Csordi/JK-FlipFlop-24H-Clock/TTL_Clock.jpg

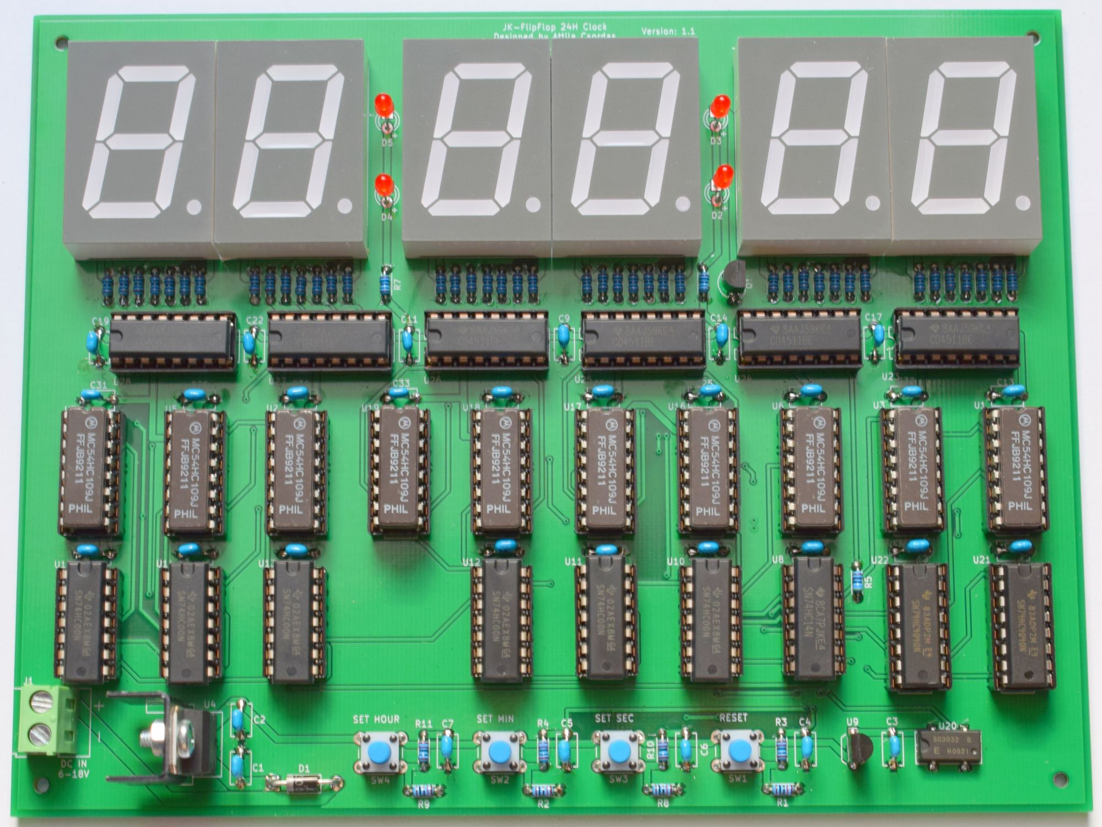
TTL_Clock.jpg
