Csordi/JK-FlipFlop-24H-Clock/Schematic.pdf

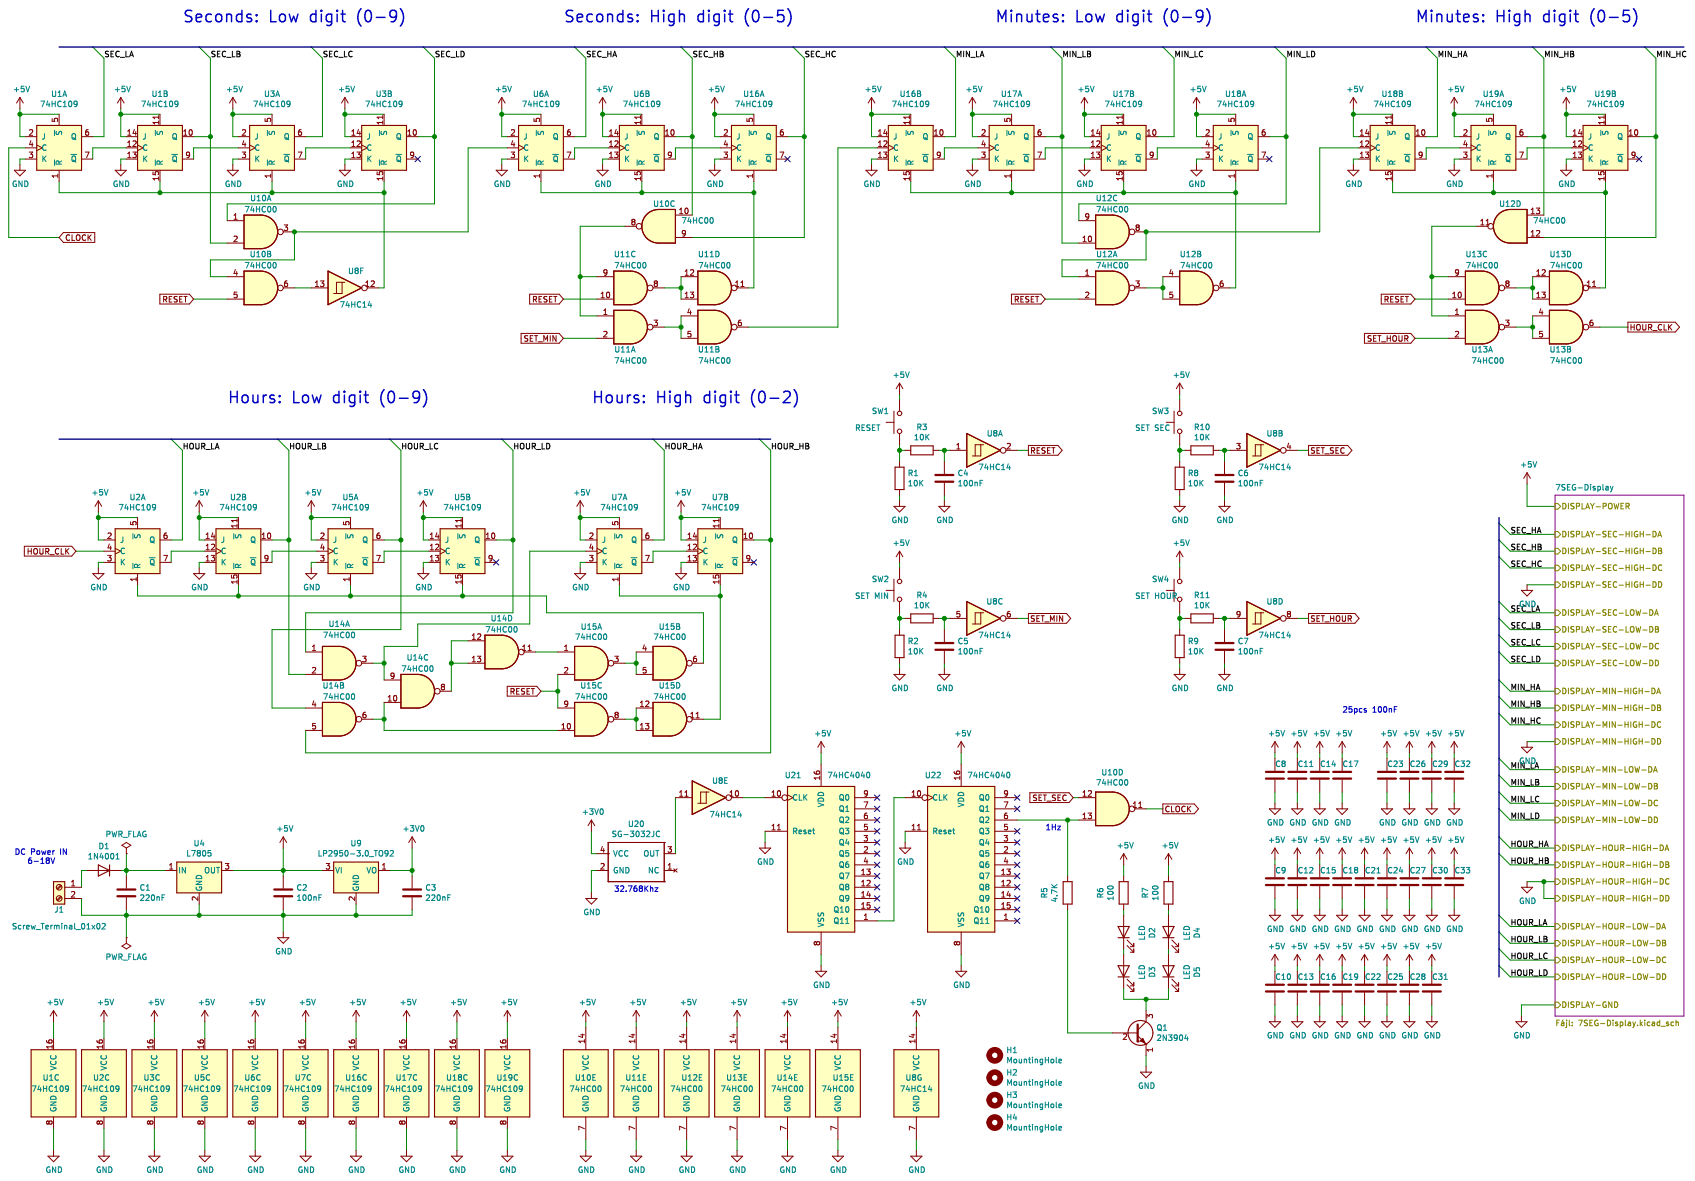
[picture p2: page 1]

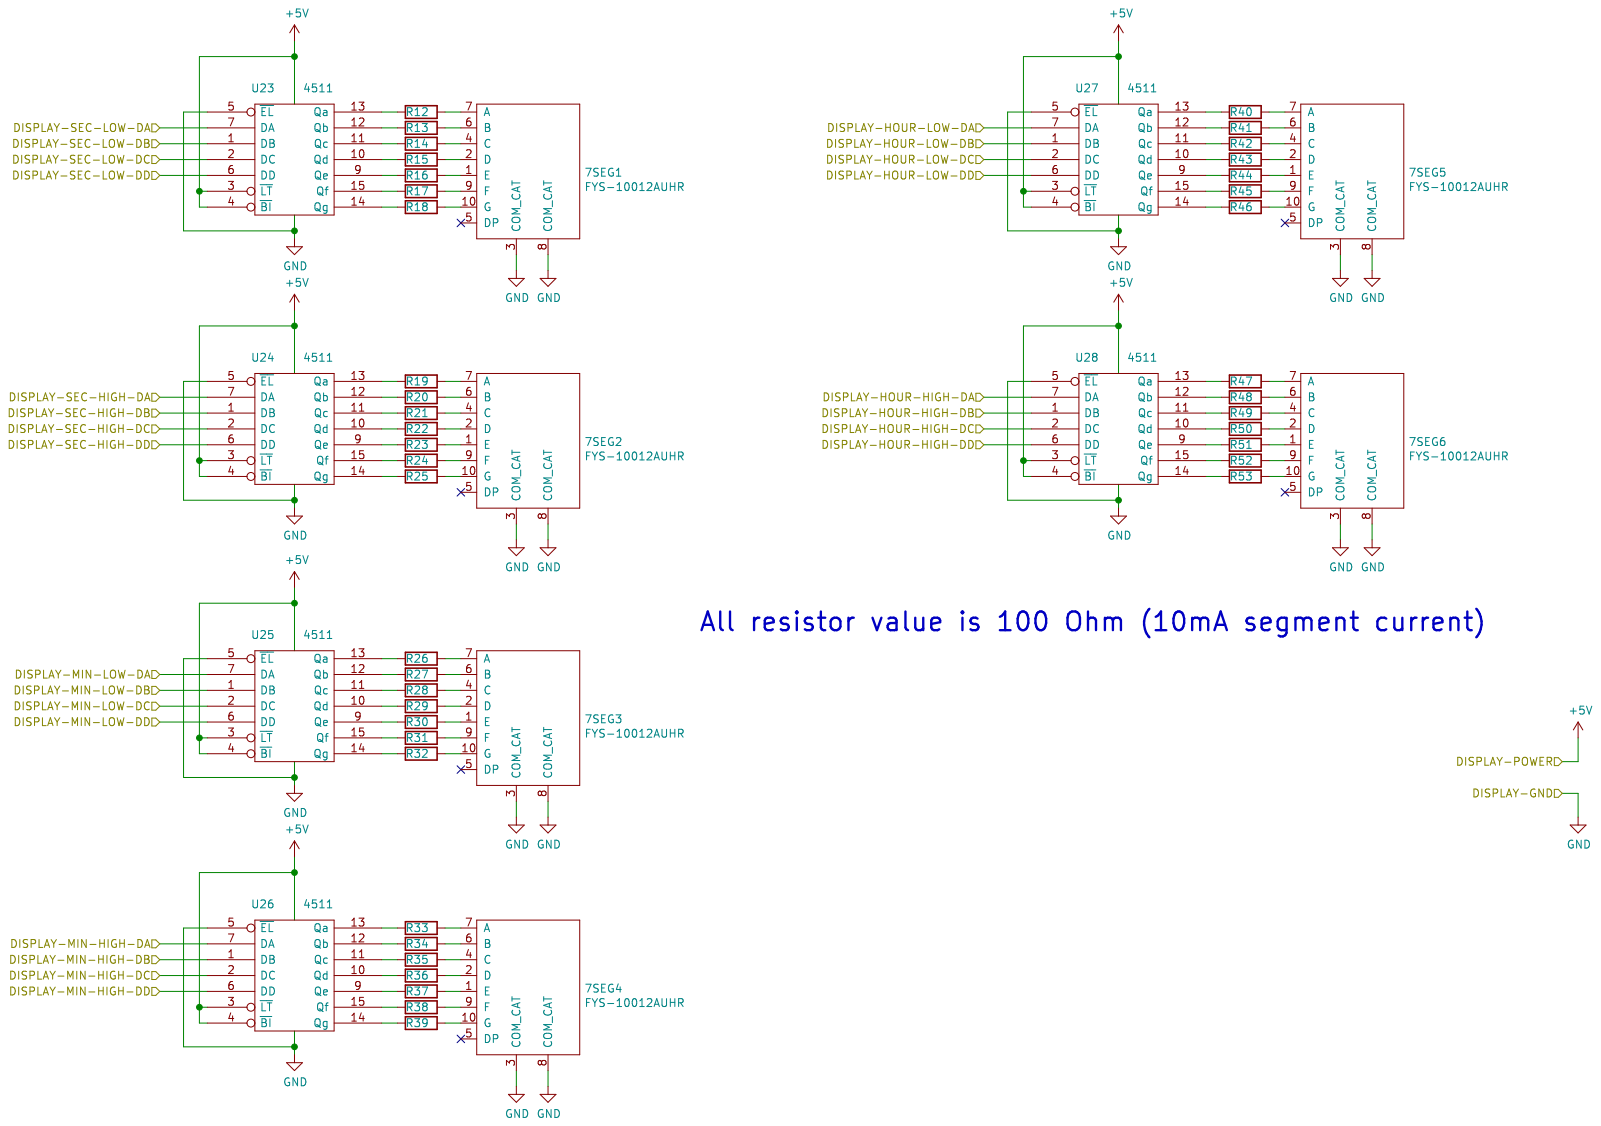
[picture p3: page 2]
