Csordi/JK-FlipFlop-24H-Clock/PCB.pdf

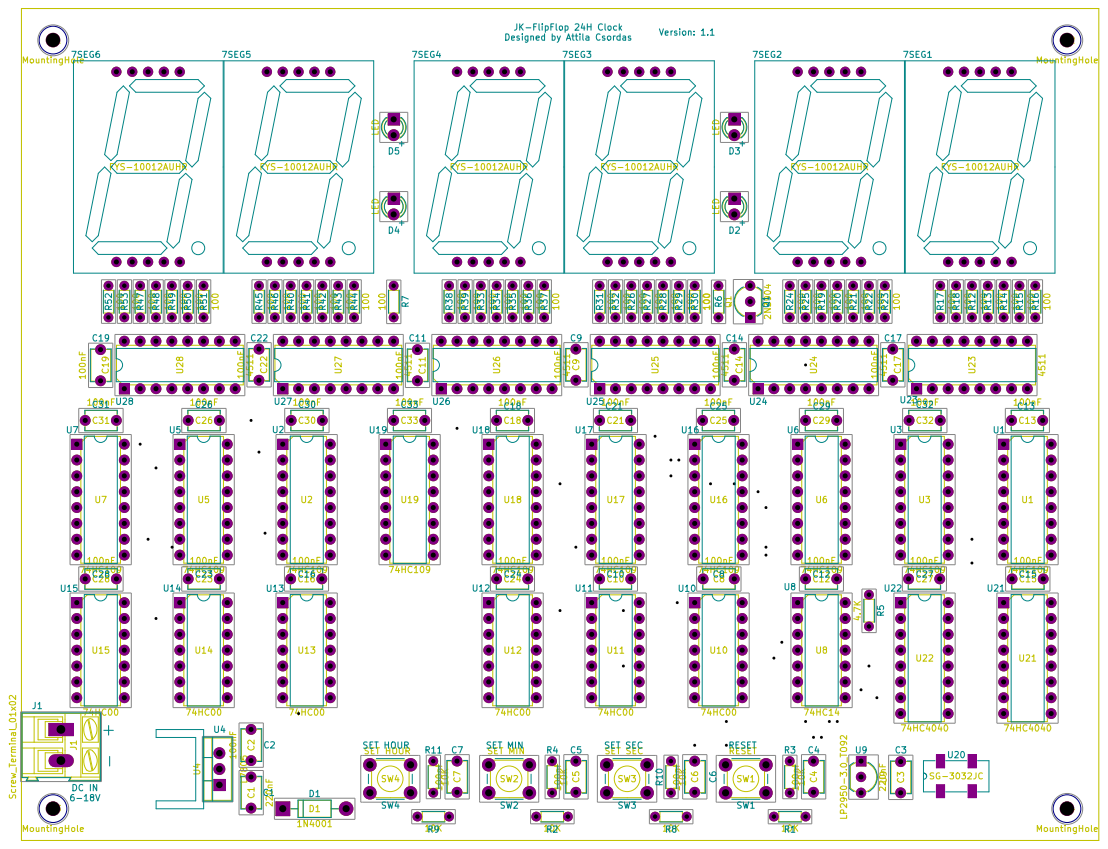
[picture p4: page 1]
