Csordi/JK-FlipFlop-24H-Clock/JK-FLipFlop-24H-Clock.kicad_pcb

## KiCad design JK-FLipFlop-24H-Clock.kicad_pcb (2024-03-14)

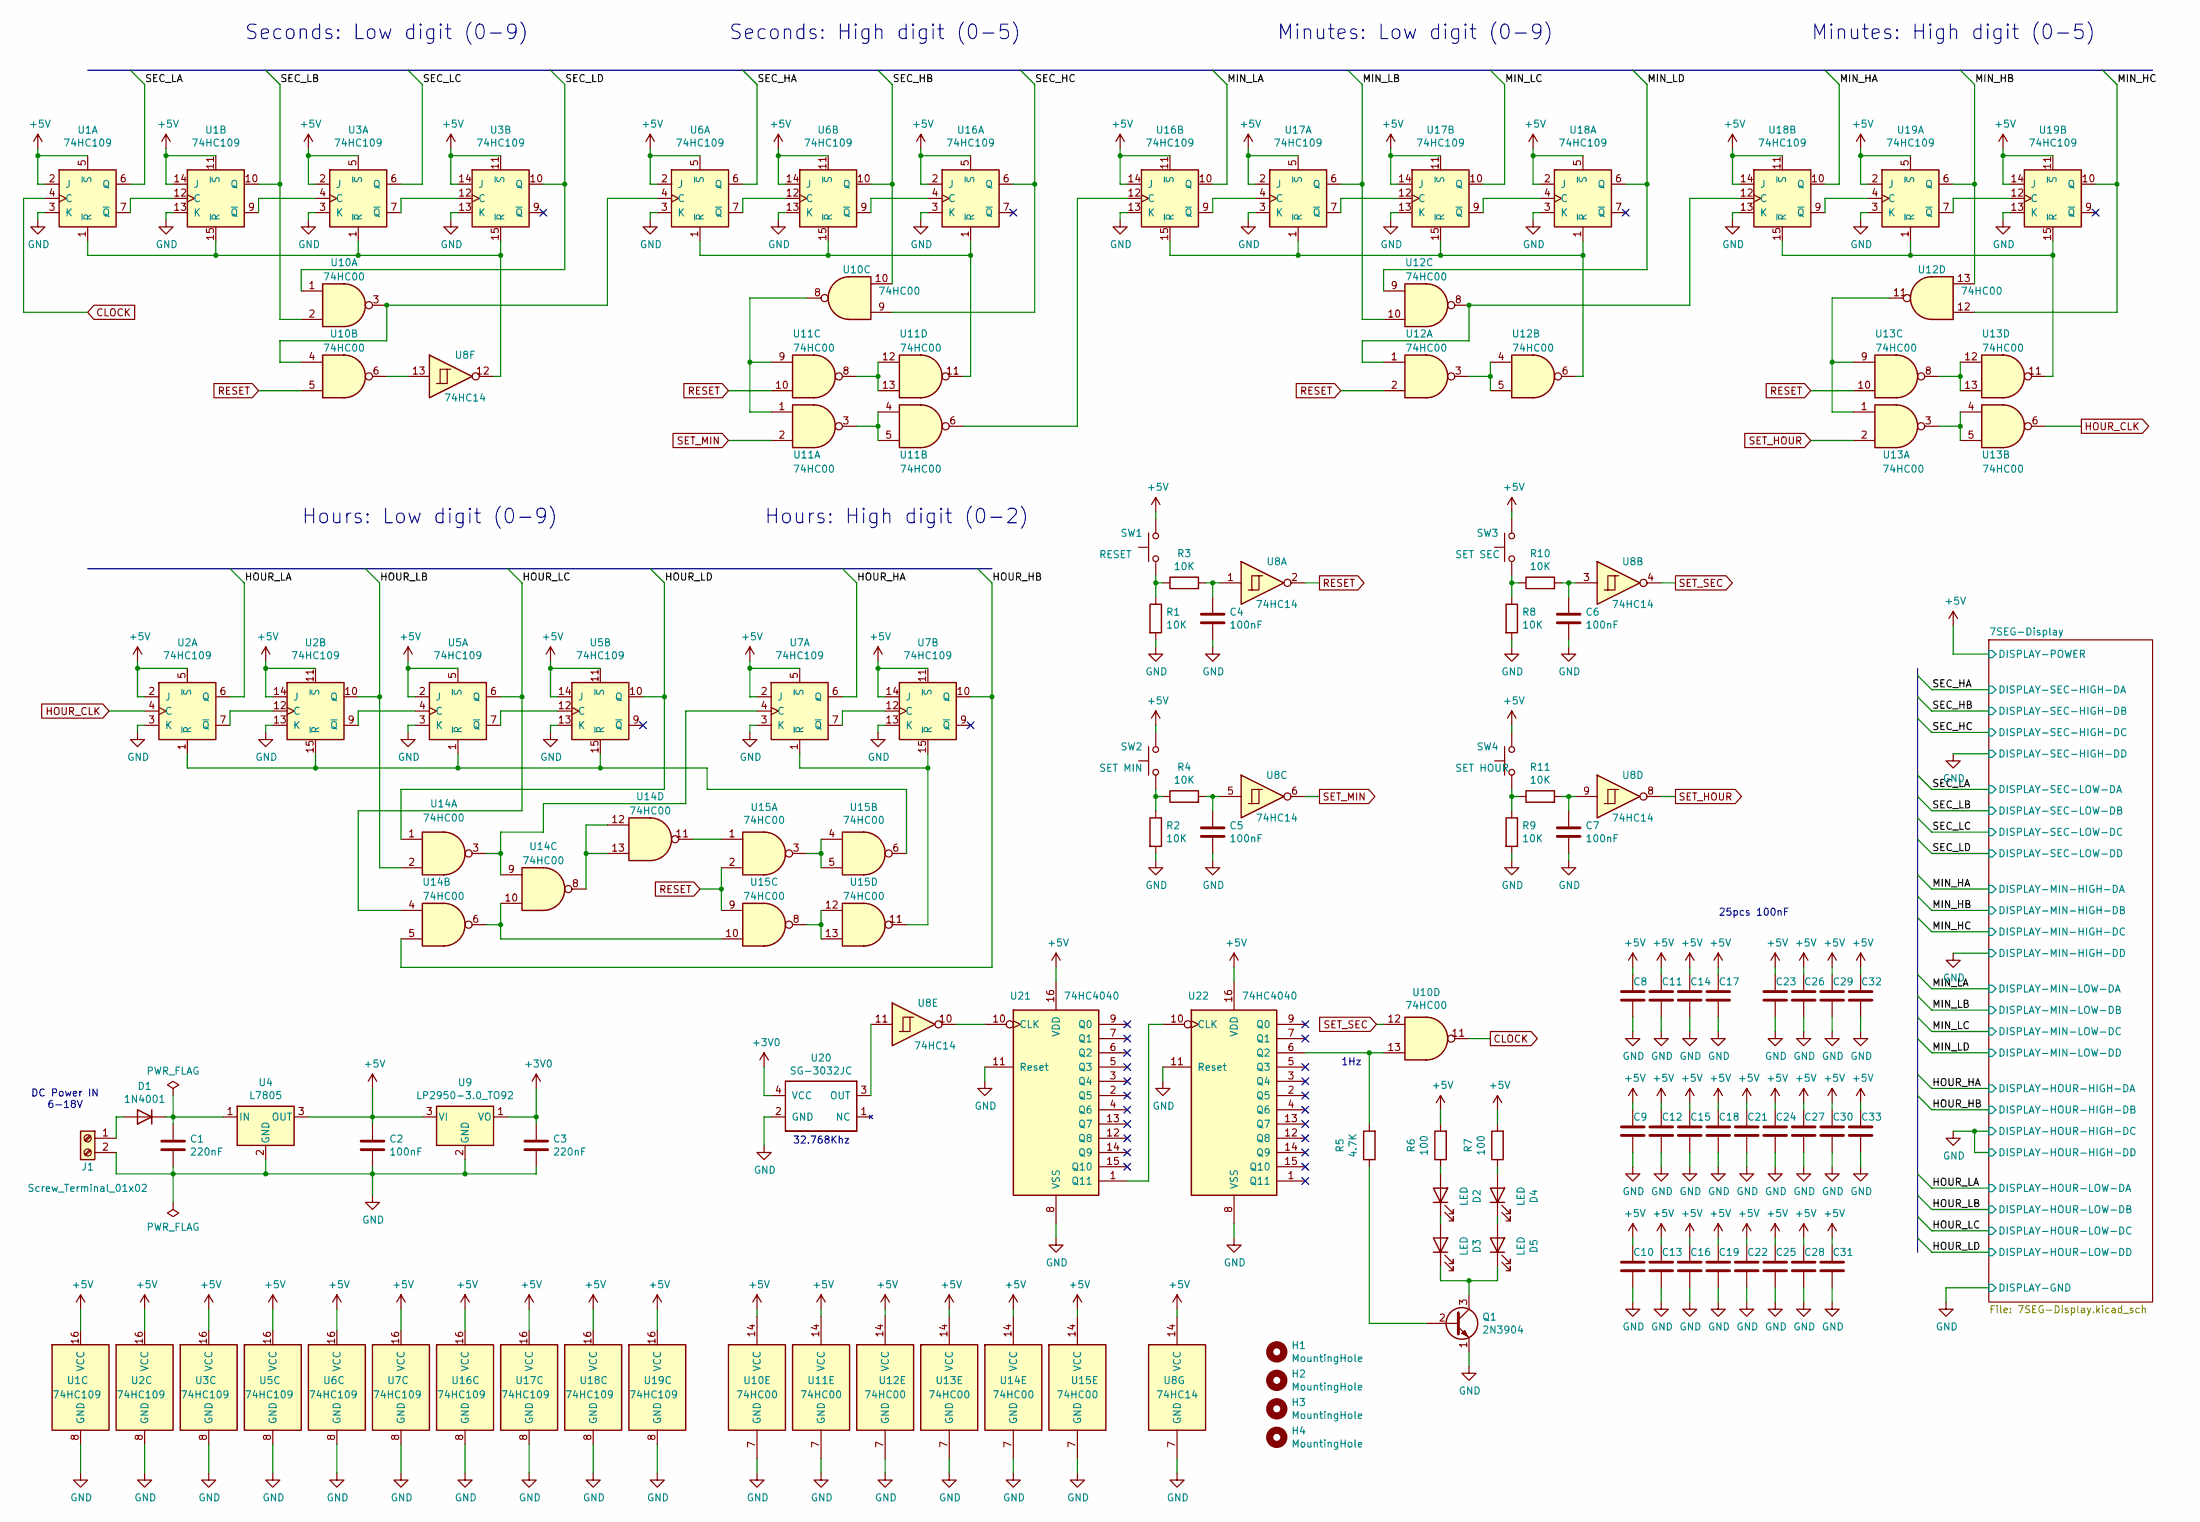
[picture p5: schematic JK-FLipFlop-24H-Clock.kicad_sch, J-K Flip/Flip 24H Clock]

Parts:
C1, C3: 220nF; C_Disc_D5.1mm_W3.2mm_P5.00mm
C2, C4, C5, C6, C7, C8, C9, C10, C11, C12, C13, C14, C15, C16, C17, C18, C19, C21, C22, C23, C24, C25, C26, C27, C28, C29, C30, C31, C32, C33: 100nF; C_Disc_D5.1mm_W3.2mm_P5.00mm
D1: 1N4001; D_DO-41_SOD81_P10.16mm_Horizontal
D2, D3, D4, D5: LED; LED_D3.0mm
H1, H2, H3, H4: MountingHole; MountingHole_2.2mm_M2
J1: Screw_Terminal_01x02; TerminalBlock_Altech_AK300-2_P5.00mm
Q1: 2N3904; TO-92_Inline_Wide
R1, R2, R3, R4, R8, R9, R10, R11: 10K; R_Axial_DIN0204_L3.6mm_D1.6mm_P5.08mm_Horizontal
R5: 4.7K; R_Axial_DIN0204_L3.6mm_D1.6mm_P5.08mm_Horizontal
R6, R7: 100; R_Axial_DIN0204_L3.6mm_D1.6mm_P5.08mm_Horizontal
SW1: RESET; SW_PUSH_6mm
SW2: SET MIN; SW_PUSH_6mm
SW3: SET SEC; SW_PUSH_6mm
SW4: SET HOUR; SW_PUSH_6mm
U1, U2, U3, U5, U6, U7, U16, U17, U18, U19: 74HC109; DIP-16_W7.62mm
U4: L7805; TO-220-3_Vertical
U8: 74HC14; DIP-14_W7.62mm
U9: LP2950-3.0_TO92; TO-92_Inline_Wide
U10, U11, U12, U13, U14, U15: 74HC00; DIP-14_W7.62mm
U20: SG-3032JC; SG-3030JC
U21, U22: 74HC4040; DIP-16_W7.62mm

Connections:
+3V0: C3.1, U9.1 (VO), U20.4 (VCC)
+5V: C2.1, C8.1, C9.1, C10.1, C11.1, C12.1, C13.1, C14.1, C15.1, C16.1, C17.1, C18.1, C19.1, C21.1, C22.1, C23.1, C24.1, C25.1, C26.1, C27.1, C28.1, C29.1, C30.1, C31.1, C32.1, C33.1, R6.2, R7.2, SW1.2, SW2.2, SW3.2, SW4.2, U1.2 (J), U1.5 (~S), U1.11 (~S), U1.14 (J), U1.16 (VCC), U2.2 (J), U2.5 (~S), U2.11 (~S), U2.14 (J), U2.16 (VCC), U3.2 (J), U3.5 (~S), U3.11 (~S), U3.14 (J), U3.16 (VCC), U4.3 (OUT), U5.2 (J), U5.5 (~S), U5.11 (~S), U5.14 (J), U5.16 (VCC), U6.2 (J), U6.5 (~S), U6.11 (~S), U6.14 (J), U6.16 (VCC), U7.2 (J), U7.5 (~S), U7.11 (~S), U7.14 (J), U7.16 (VCC), U8.14 (VCC), U9.3 (VI), U10.14 (VCC), U11.14 (VCC), U12.14 (VCC), U13.14 (VCC), U14.14 (VCC), U15.14 (VCC), U16.2 (J), U16.5 (~S), U16.11 (~S), U16.14 (J), U16.16 (VCC), U17.2 (J), U17.5 (~S), U17.11 (~S), U17.14 (J), U17.16 (VCC), U18.2 (J), U18.5 (~S), U18.11 (~S), U18.14 (J), U18.16 (VCC), U19.2 (J), U19.5 (~S), U19.11 (~S), U19.14 (J), U19.16 (VCC), U21.16 (VDD), U22.16 (VDD); also elsewhere on the board
/HOUR_HA: U7.6 (Q); also elsewhere on the board
/HOUR_HB: U7.10 (Q), U14.5; also elsewhere on the board
/HOUR_LA: U2.6 (Q); also elsewhere on the board
/HOUR_LB: U2.10 (Q), U14.2; also elsewhere on the board
/HOUR_LC: U5.6 (Q), U14.4; also elsewhere on the board
/HOUR_LD: U5.10 (Q), U14.1; also elsewhere on the board
/MIN_HA: U18.10 (Q); also elsewhere on the board
/MIN_HB: U12.13, U19.6 (Q); also elsewhere on the board
/MIN_HC: U12.12, U19.10 (Q); also elsewhere on the board
/MIN_LA: U16.10 (Q); also elsewhere on the board
/MIN_LB: U12.10, U17.6 (Q); also elsewhere on the board
/MIN_LC: U17.10 (Q); also elsewhere on the board
/MIN_LD: U12.9, U18.6 (Q); also elsewhere on the board
/SEC_HA: U6.6 (Q); also elsewhere on the board
/SEC_HB: U6.10 (Q), U10.10; also elsewhere on the board
/SEC_HC: U10.9, U16.6 (Q); also elsewhere on the board
/SEC_LA: U1.6 (Q); also elsewhere on the board
/SEC_LB: U1.10 (Q), U10.2; also elsewhere on the board
/SEC_LC: U3.6 (Q); also elsewhere on the board
/SEC_LD: U3.10 (Q), U10.1; also elsewhere on the board
CLOCK: U1.4 (C), U10.11
GND: C1.2, C2.2, C3.2, C4.2, C5.2, C6.2, C7.2, C8.2, C9.2, C10.2, C11.2, C12.2, C13.2, C14.2, C15.2, C16.2, C17.2, C18.2, C19.2, C21.2, C22.2, C23.2, C24.2, C25.2, C26.2, C27.2, C28.2, C29.2, C30.2, C31.2, C32.2, C33.2, J1.2, Q1.1 (E), R1.2, R2.2, R8.2, R9.2, U1.3 (K), U1.8 (GND), U1.13 (K), U2.3 (K), U2.8 (GND), U2.13 (K), U3.3 (K), U3.8 (GND), U3.13 (K), U4.2 (GND), U5.3 (K), U5.8 (GND), U5.13 (K), U6.3 (K), U6.8 (GND), U6.13 (K), U7.3 (K), U7.8 (GND), U7.13 (K), U8.7 (GND), U9.2 (GND), U10.7 (GND), U11.7 (GND), U12.7 (GND), U13.7 (GND), U14.7 (GND), U15.7 (GND), U16.3 (K), U16.8 (GND), U16.13 (K), U17.3 (K), U17.8 (GND), U17.13 (K), U18.3 (K), U18.8 (GND), U18.13 (K), U19.3 (K), U19.8 (GND), U19.13 (K), U20.2 (GND), U21.8 (VSS), U21.11 (Reset), U22.8 (VSS), U22.11 (Reset); also elsewhere on the board
HOUR_CLK: U2.4 (C), U13.6
unnamed: C1.1, D1.1 (K), U4.1 (IN)
unnamed: C4.1, R3.2, U8.1
unnamed: C5.1, R4.2, U8.5
unnamed: C6.1, R10.2, U8.3
unnamed: C7.1, R11.2, U8.9
unnamed: D1.2 (A), J1.1
unnamed: D2.1 (K), D3.2 (A)
unnamed: D2.2 (A), R6.1
unnamed: D3.1 (K), D5.1 (K), Q1.3 (C)
unnamed: D4.1 (K), D5.2 (A)
unnamed: D4.2 (A), R7.1
unnamed: Q1.2 (B), R5.1
unnamed: R1.1, R3.1, SW1.1
unnamed: R2.1, R4.1, SW2.1
unnamed: R5.2, U10.13, U22.6 (Q2)
unnamed: R8.1, R10.1, SW3.1
unnamed: R9.1, R11.1, SW4.1
unnamed: U1.1 (~R), U1.15 (~R), U3.1 (~R), U3.15 (~R), U8.12
unnamed: U1.9 (~Q), U3.4 (C)
unnamed: U1.7 (~Q), U1.12 (C)
unnamed: U2.9 (~Q), U5.4 (C)
unnamed: U2.7 (~Q), U2.12 (C)
unnamed: U3.7 (~Q), U3.12 (C)
unnamed: U5.7 (~Q), U5.12 (C)
unnamed: U6.7 (~Q), U6.12 (C)
unnamed: U7.7 (~Q), U7.12 (C)
unnamed: U6.4 (C), U10.3, U10.4
unnamed: U8.13, U10.6
unnamed: U10.8, U11.1, U11.9
unnamed: U11.3, U11.4, U11.5
unnamed: U11.6, U16.12 (C)
unnamed: U6.1 (~R), U6.15 (~R), U11.11, U16.1 (~R)
unnamed: U11.8, U11.12, U11.13
unnamed: U12.1, U12.8, U18.12 (C)
unnamed: U12.3, U12.4, U12.5
unnamed: U12.6, U16.15 (~R), U17.1 (~R), U17.15 (~R), U18.1 (~R)
unnamed: U12.11, U13.1, U13.9
unnamed: U13.3, U13.4, U13.5
unnamed: U13.11, U18.15 (~R), U19.1 (~R), U19.15 (~R)
unnamed: U13.8, U13.12, U13.13
unnamed: U7.4 (C), U14.3, U14.9
unnamed: U14.6, U14.10, U15.10
unnamed: U14.11, U15.1
unnamed: U14.8, U14.12, U14.13
unnamed: U15.3, U15.4, U15.5
unnamed: U2.1 (~R), U2.15 (~R), U5.1 (~R), U5.15 (~R), U15.6
unnamed: U7.1 (~R), U7.15 (~R), U15.11
unnamed: U15.8, U15.12, U15.13
unnamed: U6.9 (~Q), U16.4 (C)
unnamed: U16.9 (~Q), U17.4 (C)
unnamed: U17.9 (~Q), U18.4 (C)
unnamed: U17.7 (~Q), U17.12 (C)
unnamed: U18.9 (~Q), U19.4 (C)
unnamed: U19.7 (~Q), U19.12 (C)
unnamed: U8.11, U20.3 (OUT)
unnamed: U21.1 (Q11), U22.10 (CLK)
unnamed: U8.10, U21.10 (CLK)
RESET: U8.2, U10.5, U11.10, U12.2, U13.10, U15.2, U15.9
SET_HOUR: U8.8, U13.2
SET_MIN: U8.6, U11.2
SET_SEC: U8.4, U10.12

Notes on the sheet:
Hours: High digit (0-2)
Minutes: High digit (0-5)
Seconds: High digit (0-5)
1Hz
DC Power IN 6-18V
25pcs 100nF
Hours: Low digit (0-9)
32.768Khz
Seconds: Low digit (0-9)
Minutes: Low digit (0-9)

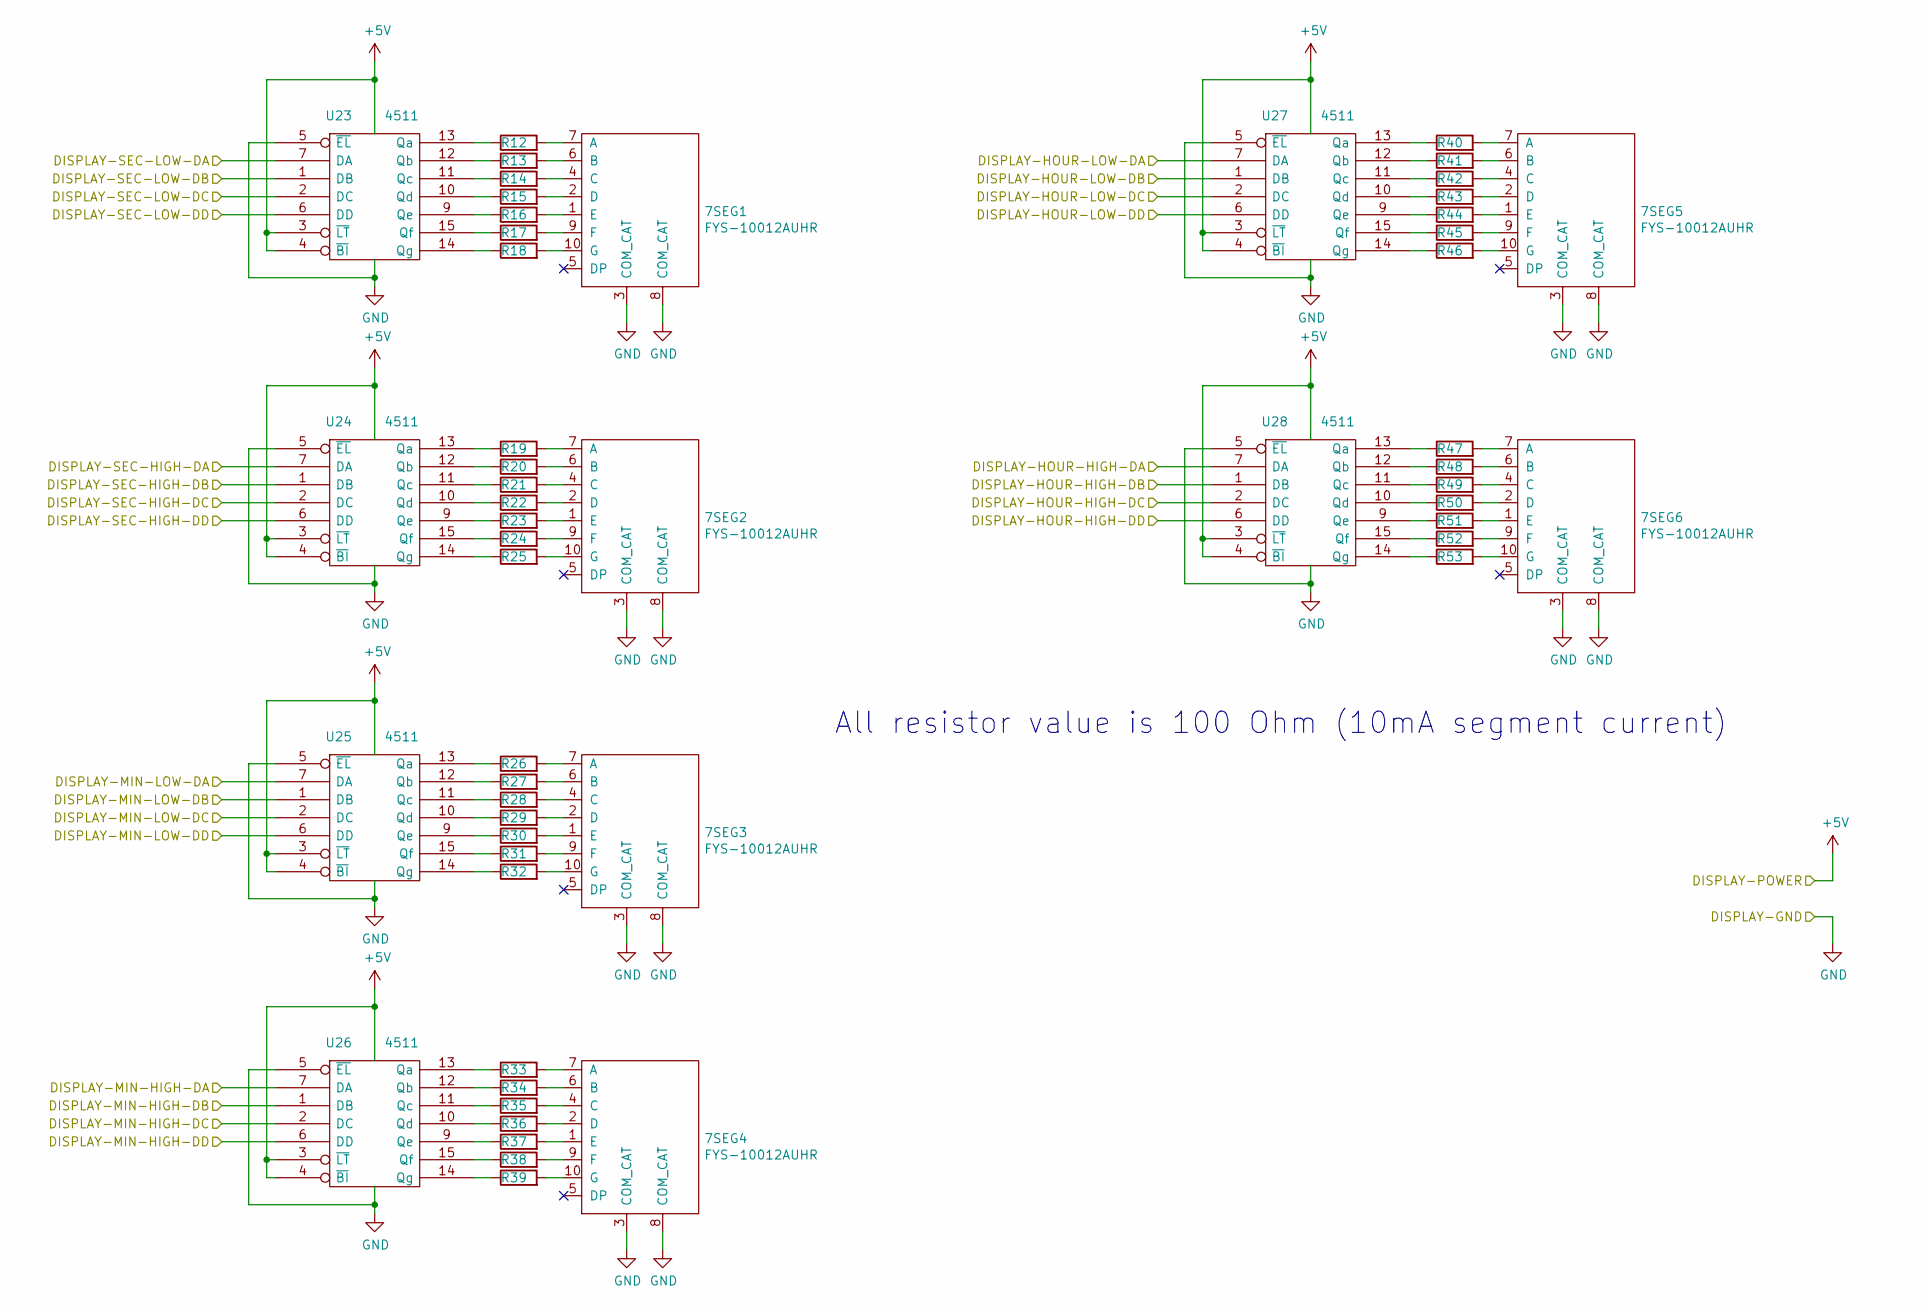
[picture p6: schematic 7SEG-Display.kicad_sch, J-K Flip/Flip 24H Clock]

Parts:
7SEG1, 7SEG2, 7SEG3, 7SEG4, 7SEG5, 7SEG6: FYS-10012AUHR; fys-10012auhr
R12, R13, R14, R15, R16, R17, R18, R19, R20, R21, R22, R23, R24, R25, R26, R27, R28, R29, R30, R31, R32, R33, R34, R35, R36, R37, R38, R39, R40, R41, R42, R43, R44, R45, R46, R47, R48, R49, R50, R51, R52, R53: 100; R_Axial_DIN0204_L3.6mm_D1.6mm_P5.08mm_Horizontal
U23, U24, U25, U26, U27, U28: 4511; DIP-16_W7.62mm

Connections:
+5V: U23.3 (~LT), U23.4 (~BI), U23.16 (Vdd), U24.3 (~LT), U24.4 (~BI), U24.16 (Vdd), U25.3 (~LT), U25.4 (~BI), U25.16 (Vdd), U26.3 (~LT), U26.4 (~BI), U26.16 (Vdd), U27.3 (~LT), U27.4 (~BI), U27.16 (Vdd), U28.3 (~LT), U28.4 (~BI), U28.16 (Vdd); also elsewhere on the board
/HOUR_HA: U28.7 (DA); also elsewhere on the board
/HOUR_HB: U28.1 (DB); also elsewhere on the board
/HOUR_LA: U27.7 (DA); also elsewhere on the board
/HOUR_LB: U27.1 (DB); also elsewhere on the board
/HOUR_LC: U27.2 (DC); also elsewhere on the board
/HOUR_LD: U27.6 (DD); also elsewhere on the board
/MIN_HA: U26.7 (DA); also elsewhere on the board
/MIN_HB: U26.1 (DB); also elsewhere on the board
/MIN_HC: U26.2 (DC); also elsewhere on the board
/MIN_LA: U25.7 (DA); also elsewhere on the board
/MIN_LB: U25.1 (DB); also elsewhere on the board
/MIN_LC: U25.2 (DC); also elsewhere on the board
/MIN_LD: U25.6 (DD); also elsewhere on the board
/SEC_HA: U24.7 (DA); also elsewhere on the board
/SEC_HB: U24.1 (DB); also elsewhere on the board
/SEC_HC: U24.2 (DC); also elsewhere on the board
/SEC_LA: U23.7 (DA); also elsewhere on the board
/SEC_LB: U23.1 (DB); also elsewhere on the board
/SEC_LC: U23.2 (DC); also elsewhere on the board
/SEC_LD: U23.6 (DD); also elsewhere on the board
GND: 7SEG1.3 (COM_CAT), 7SEG1.8 (COM_CAT), 7SEG2.3 (COM_CAT), 7SEG2.8 (COM_CAT), 7SEG3.3 (COM_CAT), 7SEG3.8 (COM_CAT), 7SEG4.3 (COM_CAT), 7SEG4.8 (COM_CAT), 7SEG5.3 (COM_CAT), 7SEG5.8 (COM_CAT), 7SEG6.3 (COM_CAT), 7SEG6.8 (COM_CAT), U23.5 (~EL), U23.8 (Vss), U24.5 (~EL), U24.6 (DD), U24.8 (Vss), U25.5 (~EL), U25.8 (Vss), U26.5 (~EL), U26.6 (DD), U26.8 (Vss), U27.5 (~EL), U27.8 (Vss), U28.2 (DC), U28.5 (~EL), U28.6 (DD), U28.8 (Vss); also elsewhere on the board
unnamed: 7SEG1.1 (E), R16.2
unnamed: 7SEG1.2 (D), R15.2
unnamed: 7SEG1.4 (C), R14.2
unnamed: 7SEG1.6 (B), R13.2
unnamed: 7SEG1.7 (A), R12.2
unnamed: 7SEG1.9 (F), R17.2
unnamed: 7SEG1.10 (G), R18.2
unnamed: 7SEG2.1 (E), R23.2
unnamed: 7SEG2.2 (D), R22.2
unnamed: 7SEG2.4 (C), R21.2
unnamed: 7SEG2.6 (B), R20.2
unnamed: 7SEG2.7 (A), R19.2
unnamed: 7SEG2.9 (F), R24.2
unnamed: 7SEG2.10 (G), R25.2
unnamed: 7SEG3.1 (E), R30.2
unnamed: 7SEG3.2 (D), R29.2
unnamed: 7SEG3.4 (C), R28.2
unnamed: 7SEG3.6 (B), R27.2
unnamed: 7SEG3.7 (A), R26.2
unnamed: 7SEG3.9 (F), R31.2
unnamed: 7SEG3.10 (G), R32.2
unnamed: 7SEG4.1 (E), R37.2
unnamed: 7SEG4.2 (D), R36.2
unnamed: 7SEG4.4 (C), R35.2
unnamed: 7SEG4.6 (B), R34.2
unnamed: 7SEG4.7 (A), R33.2
unnamed: 7SEG4.9 (F), R38.2
unnamed: 7SEG4.10 (G), R39.2
unnamed: 7SEG5.1 (E), R44.2
unnamed: 7SEG5.2 (D), R43.2
unnamed: 7SEG5.4 (C), R42.2
unnamed: 7SEG5.6 (B), R41.2
unnamed: 7SEG5.7 (A), R40.2
unnamed: 7SEG5.9 (F), R45.2
unnamed: 7SEG5.10 (G), R46.2
unnamed: 7SEG6.1 (E), R51.2
unnamed: 7SEG6.2 (D), R50.2
unnamed: 7SEG6.4 (C), R49.2
unnamed: 7SEG6.6 (B), R48.2
unnamed: 7SEG6.7 (A), R47.2
unnamed: 7SEG6.9 (F), R52.2
unnamed: 7SEG6.10 (G), R53.2
unnamed: R12.1, U23.13 (Qa)
unnamed: R13.1, U23.12 (Qb)
unnamed: R14.1, U23.11 (Qc)
unnamed: R15.1, U23.10 (Qd)
unnamed: R16.1, U23.9 (Qe)
unnamed: R17.1, U23.15 (Qf)
unnamed: R18.1, U23.14 (Qg)
unnamed: R19.1, U24.13 (Qa)
unnamed: R20.1, U24.12 (Qb)
unnamed: R21.1, U24.11 (Qc)
unnamed: R22.1, U24.10 (Qd)
unnamed: R23.1, U24.9 (Qe)
unnamed: R24.1, U24.15 (Qf)
unnamed: R25.1, U24.14 (Qg)
unnamed: R26.1, U25.13 (Qa)
unnamed: R27.1, U25.12 (Qb)
unnamed: R28.1, U25.11 (Qc)
unnamed: R29.1, U25.10 (Qd)
unnamed: R30.1, U25.9 (Qe)
unnamed: R31.1, U25.15 (Qf)
unnamed: R32.1, U25.14 (Qg)
unnamed: R33.1, U26.13 (Qa)
unnamed: R34.1, U26.12 (Qb)
unnamed: R35.1, U26.11 (Qc)
unnamed: R36.1, U26.10 (Qd)
unnamed: R37.1, U26.9 (Qe)
unnamed: R38.1, U26.15 (Qf)
unnamed: R39.1, U26.14 (Qg)
unnamed: R40.1, U27.13 (Qa)
unnamed: R41.1, U27.12 (Qb)
unnamed: R42.1, U27.11 (Qc)
unnamed: R43.1, U27.10 (Qd)
unnamed: R44.1, U27.9 (Qe)
unnamed: R45.1, U27.15 (Qf)
unnamed: R46.1, U27.14 (Qg)
unnamed: R47.1, U28.13 (Qa)
unnamed: R48.1, U28.12 (Qb)
unnamed: R49.1, U28.11 (Qc)
unnamed: R50.1, U28.10 (Qd)
unnamed: R51.1, U28.9 (Qe)
unnamed: R52.1, U28.15 (Qf)
unnamed: R53.1, U28.14 (Qg)

Notes on the sheet:
All resistor value is 100 Ohm (10mA segment current)

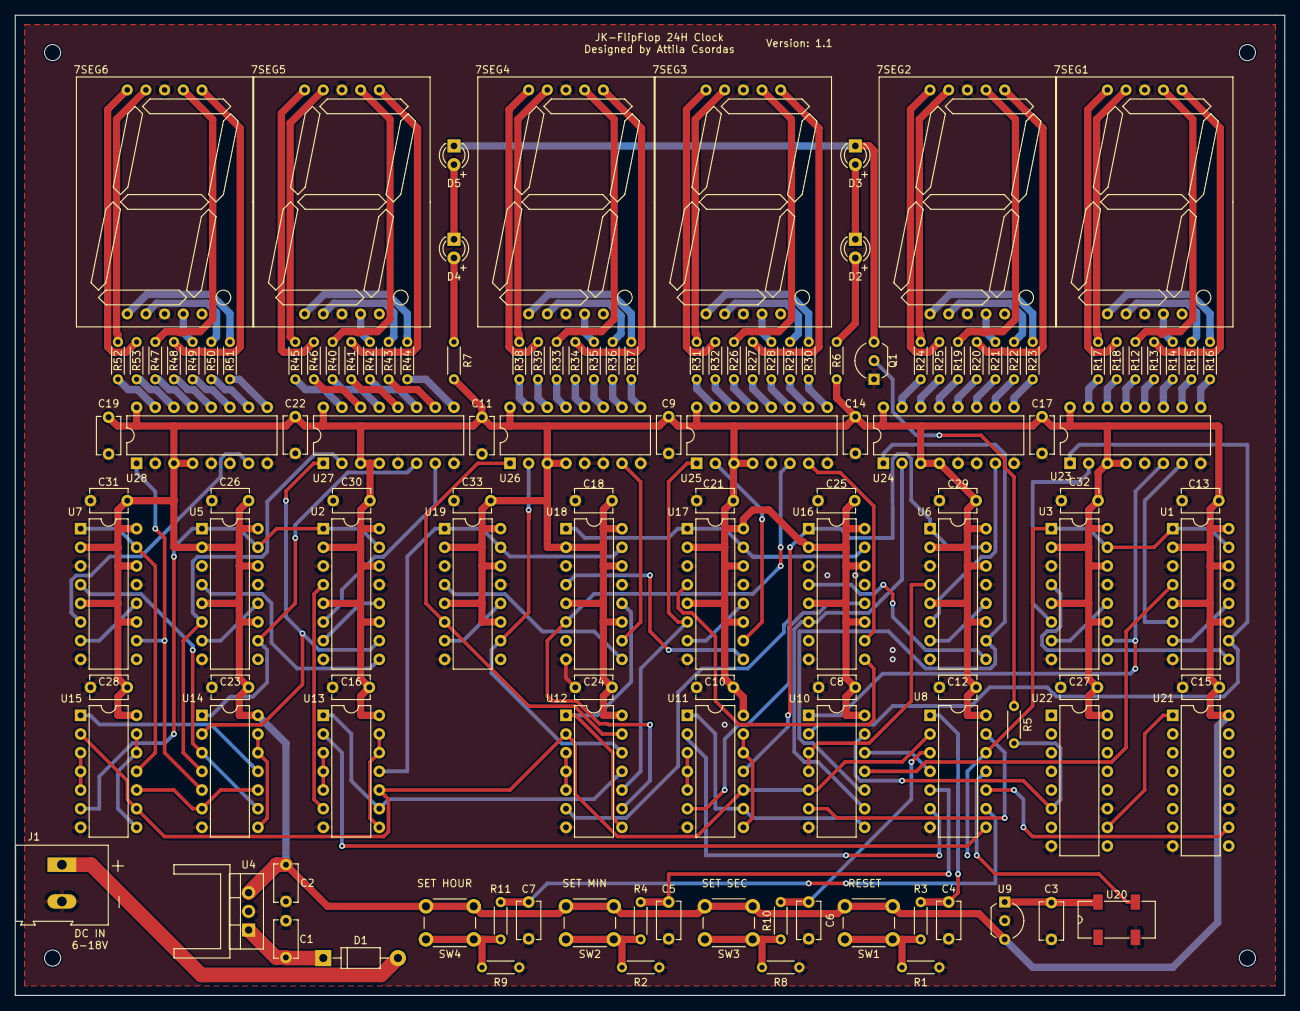
[picture p7: board JK-FLipFlop-24H-Clock.kicad_pcb from above]

Board: 2 copper layers, 172.7 x 133.3 mm, 134 parts (0 on the bottom side), 170 nets.
