Csordi/JK-FlipFlop-24H-Clock/(commit log)

2020-05-09 Add files via upload
    Error fix: HOUR digits reset and clock pulse circuit fix
    Optimization: I remove one of the 74HC00
    [7SEG-Display.sch, JK-FLipFlop-24H-Clock.kicad_pcb, JK-FLipFlop-24H-Clock.sch]
2024-03-14 Schematic + PCB Update
    [7SEG-Display.kicad_sch, JK-FLipFlop-24H-Clock.kicad_pcb, JK-FLipFlop-24H-Clock.kicad_sch]
