Csordi/JK-FlipFlop-24H-Clock/(notices)

Notices in the files:
JK-FLipFlop-24H-Clock.sch:
Licensed under CERN OHL v.1.2
